Lukski/The-Tasting-Device/README.md

# The-Tasting-Device
A virtual taste interface, created as a bachelor project for University of Technology Vienna
