Lukski/The-Tasting-Device/Case/box_full.stl

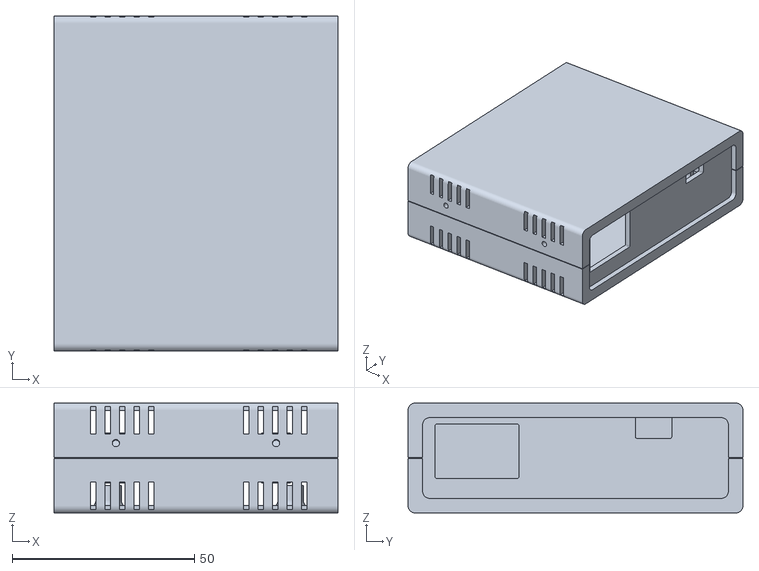
[picture p3: CAD file, 2020-11-06]
Case/box_full.stl
78.0 x 92.0 x 30.2
