Lukski/The-Tasting-Device/Case/box_top.stl

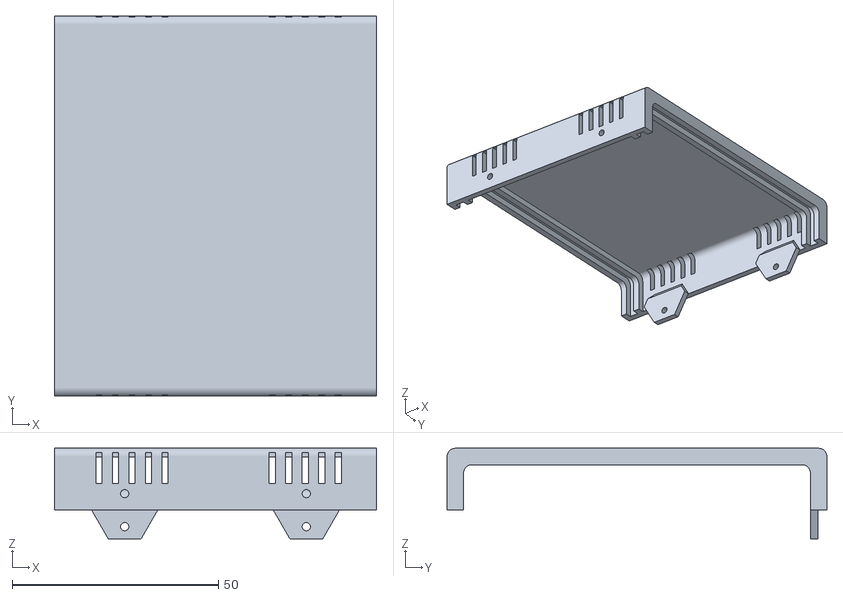
[picture p4: CAD file, 2020-11-06]
Case/box_top.stl
78.0 x 92.0 x 21.9
