Lukski/The-Tasting-Device/Mouthpiece/TastingDevice_mouthpiece.FCStd

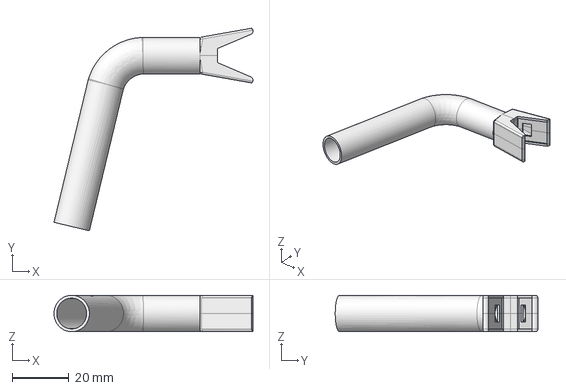
[picture p5: CAD file, 2020-11-06]
Mouthpiece/TastingDevice_mouthpiece.FCStd
69.9 x 71.1 x 12.8 mm
