Lukski/The-Tasting-Device/Case/tasting_device_case.obj

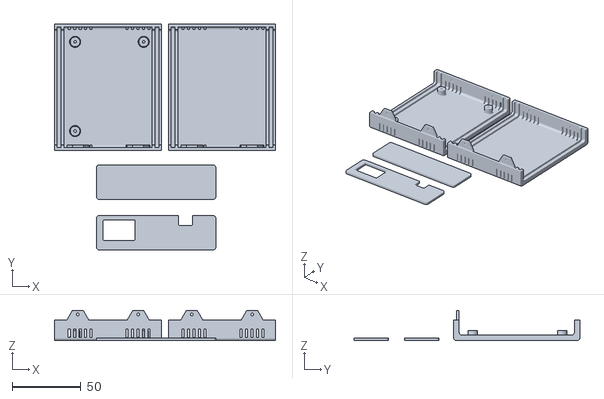
[picture p6: CAD file, 2020-11-06]
Case/tasting_device_case.obj
161.0 x 164.6 x 21.9
