Lukski/The-Tasting-Device/Mouthpiece/tasting_device_model_v2.obj

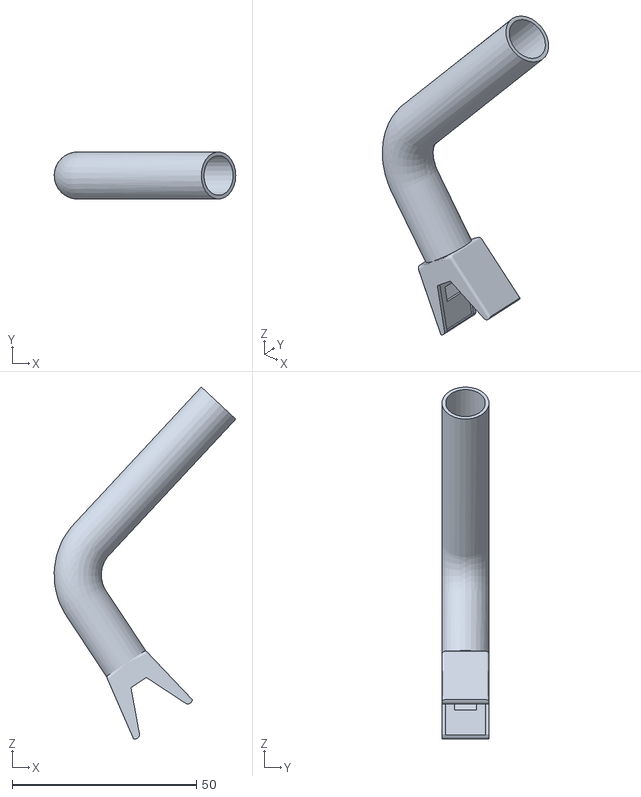
[picture p7: CAD file, 2020-11-06]
Mouthpiece/tasting_device_model_v2.obj
49.3 x 12.8 x 95.5
