Lukski/The-Tasting-Device/Case/box_back.stl

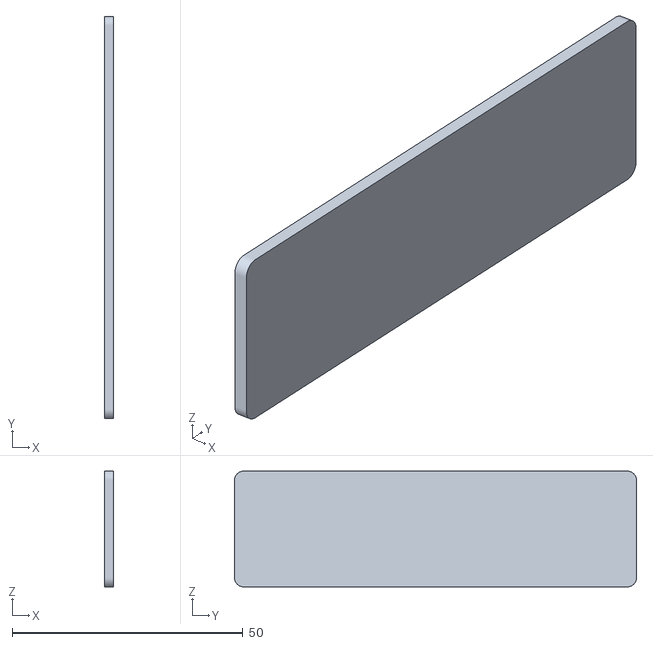
[picture p8: CAD file, 2020-11-06]
Case/box_back.stl
2.00 x 87.1 x 25.1
