Lukski/The-Tasting-Device/Case/box_front.stl

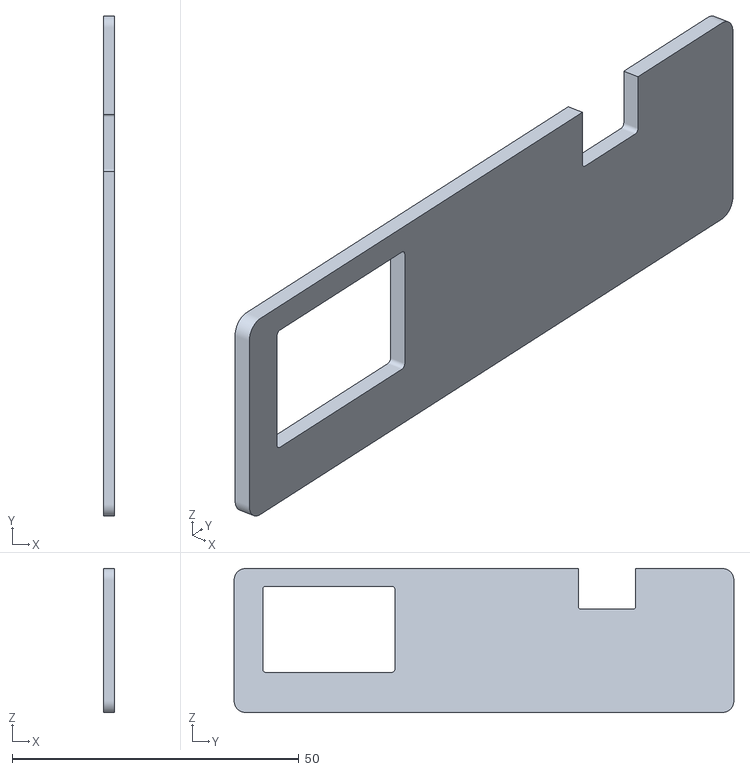
[picture p9: CAD file, 2020-11-06]
Case/box_front.stl
2.00 x 87.1 x 25.1
