Lukski/The-Tasting-Device/Case/box_test.stl

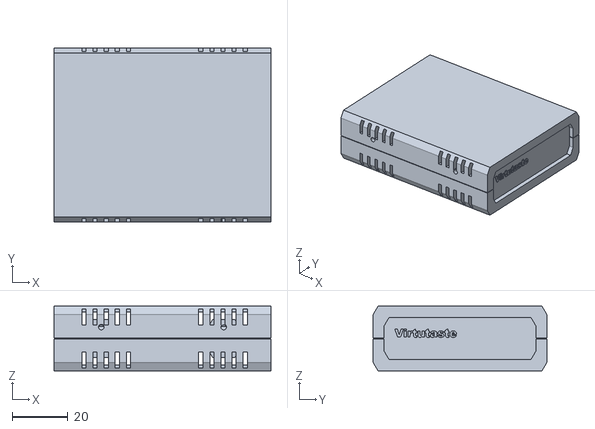
[picture p10: CAD file, 2020-11-06]
Case/box_test.stl
78.0 x 62.5 x 23.2
