Lukski/The-Tasting-Device/(list of files, cad)

Other CAD files:
Case/box_bottom.stl
