Lukski/The-Tasting-Device/(commit log)

2020-11-06 put the project on git
    [box_back.stl, box_bottom.stl, box_front.stl, box_full.stl, box_test.stl, box_top.stl, tasting_device_case.obj, tasting_device_model_v2.obj]
2020-11-06 Add documentation + some files i forgot
    [TastingDevice_mouthpiece.FCStd]
